pfielding/Voron/Mods/Filament_Spool_Rack/Stls/Bowden Mount.stl

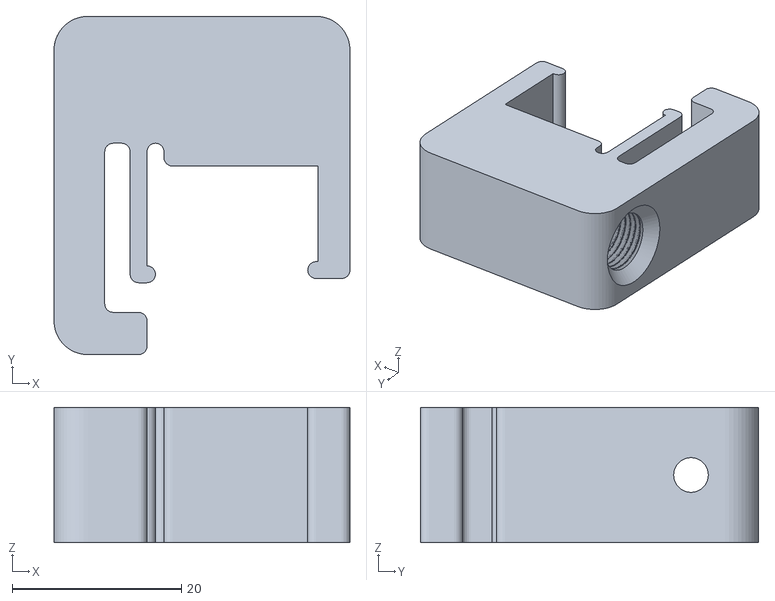
[picture p14: CAD file, 2023-10-17]
Mods/Filament_Spool_Rack/Stls/Bowden Mount.stl
35.0 x 40.0 x 16.0
