pfielding/Voron/Mods/Pika_Extended_Length_Mod/Stls/bar-clip-6.stl

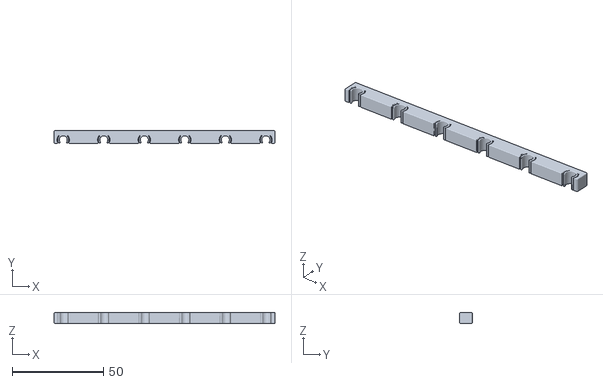
[picture p15: CAD file, 2023-10-17]
Mods/Pika_Extended_Length_Mod/Stls/bar-clip-6.stl
121.3 x 6.89 x 6.00
