pfielding/Voron/Mods/Filament_Spool_Rack/Stls/Slider Standalone.stl

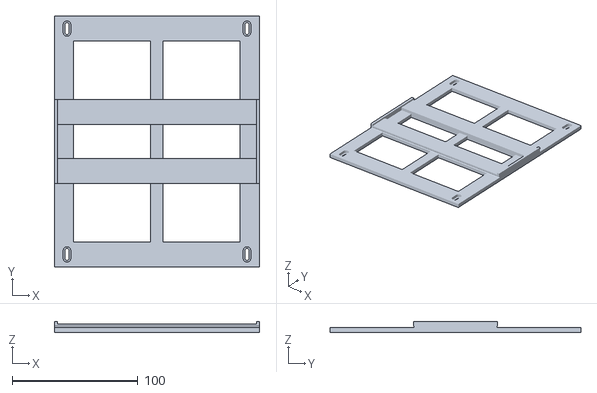
[picture p16: CAD file, 2023-10-17]
Mods/Filament_Spool_Rack/Stls/Slider Standalone.stl
163.4 x 200.0 x 8.93
