pfielding/Voron/Mods/Pika_Extended_Length_Mod/Stls/bar-clip-9.stl

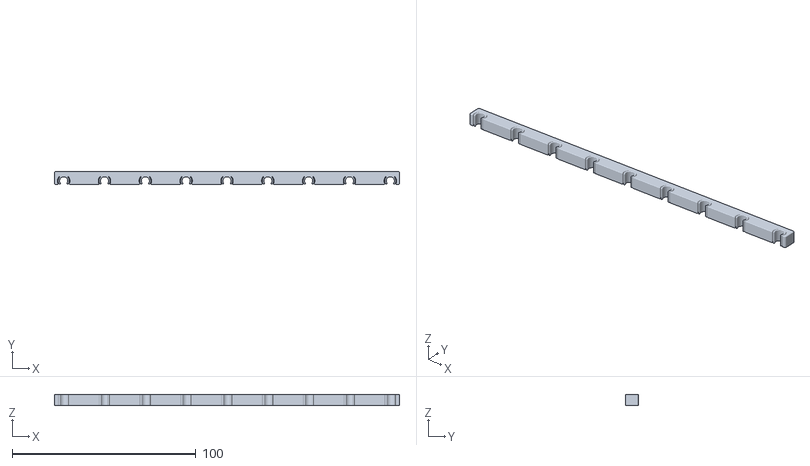
[picture p17: CAD file, 2023-10-17]
Mods/Pika_Extended_Length_Mod/Stls/bar-clip-9.stl
188.0 x 6.89 x 6.00
