pfielding/Voron/Mods/Pika_Extended_Length_Mod/Stls/bar-clip-2.stl

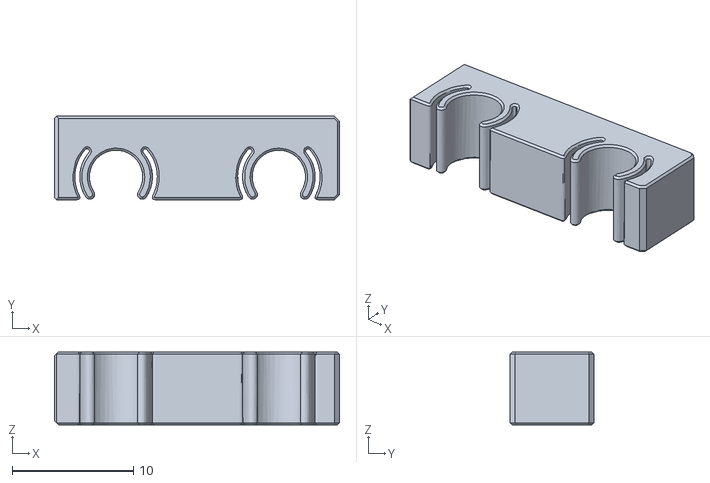
[picture p18: CAD file, 2023-10-17]
Mods/Pika_Extended_Length_Mod/Stls/bar-clip-2.stl
23.5 x 6.89 x 6.00
