pfielding/Voron/Mods/Filament_Spool_Rack/Stls/ERCF Rack Bracket.stl

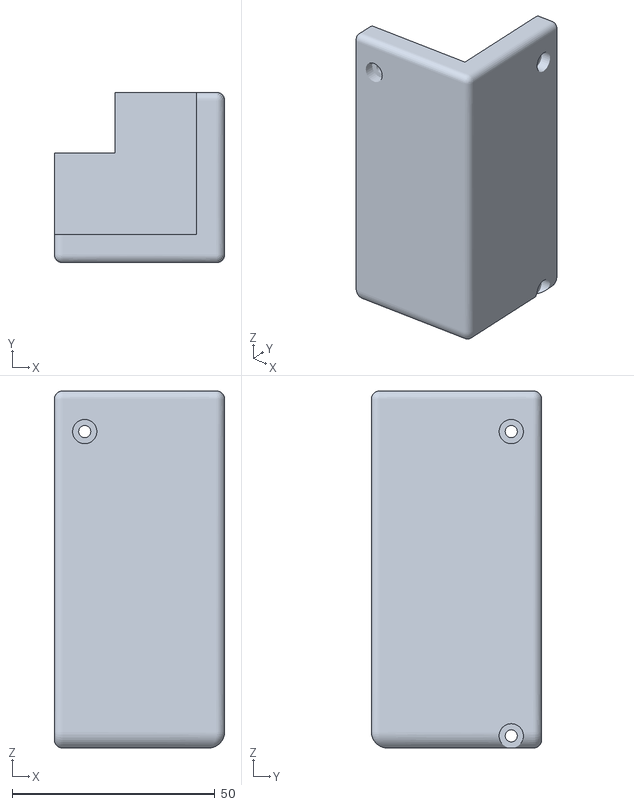
[picture p19: CAD file, 2023-10-17]
Mods/Filament_Spool_Rack/Stls/ERCF Rack Bracket.stl
42.0 x 42.0 x 88.0
