pfielding/Voron/Mods/Pika_Extended_Length_Mod/Stls/filament_bracket_mounting_plate_ercf_notches.stl

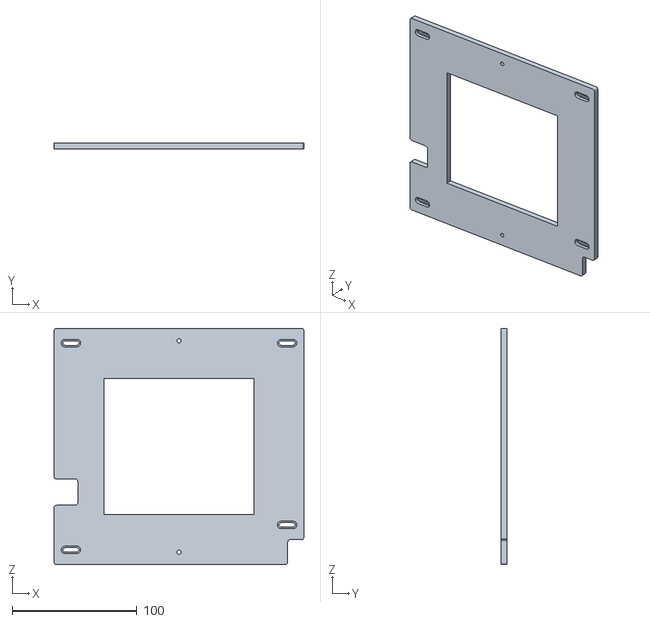
[picture p20: CAD file, 2023-10-17]
Mods/Pika_Extended_Length_Mod/Stls/filament_bracket_mounting_plate_ercf_notches.stl
200.0 x 5.00 x 189.0
