pfielding/Voron/Mods/Filament_Spool_Rack/Stls/Slider Middle.stl

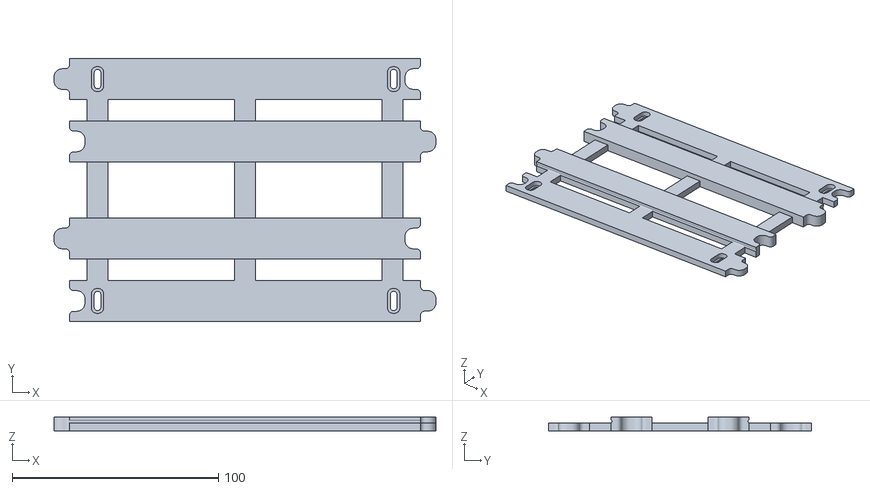
[picture p21: CAD file, 2023-10-17]
Mods/Filament_Spool_Rack/Stls/Slider Middle.stl
185.0 x 127.5 x 7.00
