pfielding/Voron/Mods/Pika_Extended_Length_Mod/Stls/buffer-front-long-a.stl

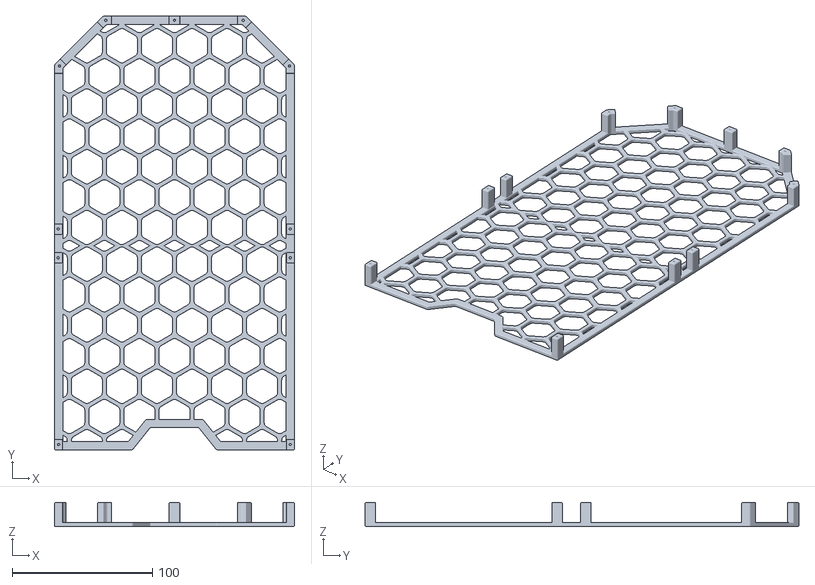
[picture p22: CAD file, 2023-08-23]
Mods/Pika_Extended_Length_Mod/Stls/buffer-front-long-a.stl
171.2 x 309.4 x 17.2
