pfielding/Voron/Mods/Filament_Spool_Rack/Stls/Heatset Side.stl

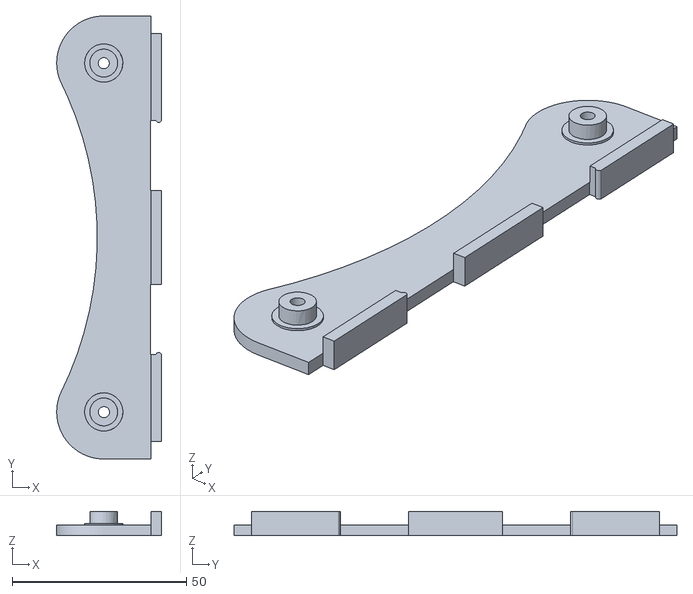
[picture p23: CAD file, 2023-10-17]
Mods/Filament_Spool_Rack/Stls/Heatset Side.stl
30.0 x 127.0 x 7.00
