pfielding/Voron/Mods/Pika_Extended_Length_Mod/Stls/array-front-with-mount-short.stl

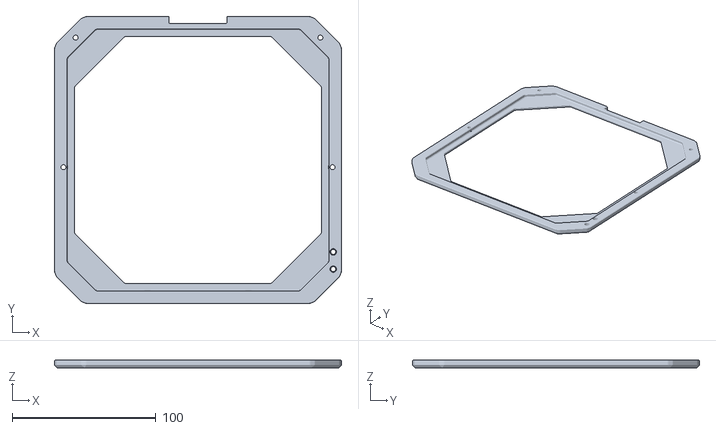
[picture p24: CAD file, 2023-08-23]
Mods/Pika_Extended_Length_Mod/Stls/array-front-with-mount-short.stl
200.0 x 200.0 x 5.40
