pfielding/Voron/Mods/Filament_Spool_Rack/Stls/Slider_End.stl

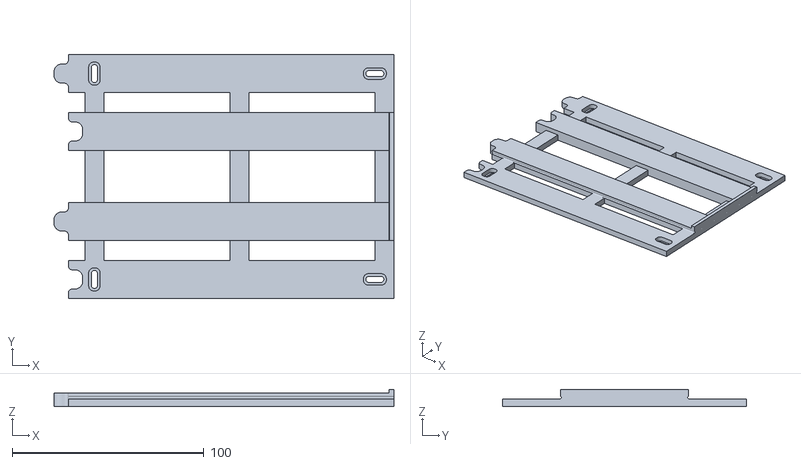
[picture p25: CAD file, 2023-10-17]
Mods/Filament_Spool_Rack/Stls/Slider_End.stl
177.5 x 127.5 x 9.00
