pfielding/Voron/Mods/Pika_Extended_Length_Mod/Stls/pika-tube-support-6-buffers-v3.stl

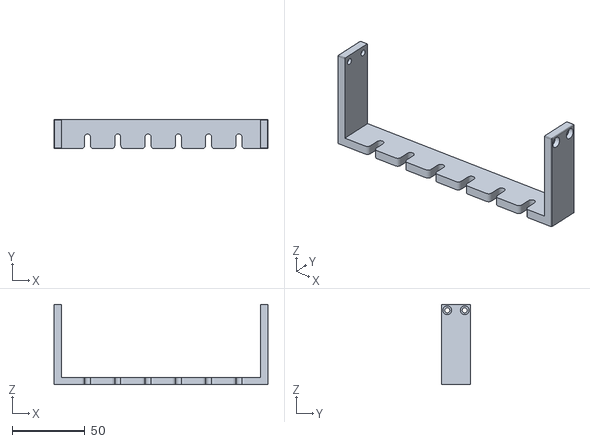
[picture p27: CAD file, 2023-08-23]
Mods/Pika_Extended_Length_Mod/Stls/pika-tube-support-6-buffers-v3.stl
147.0 x 20.0 x 55.0
