pfielding/Voron/Mods/Pika_Extended_Length_Mod/Stls/array-back-with-mount-long-b.stl

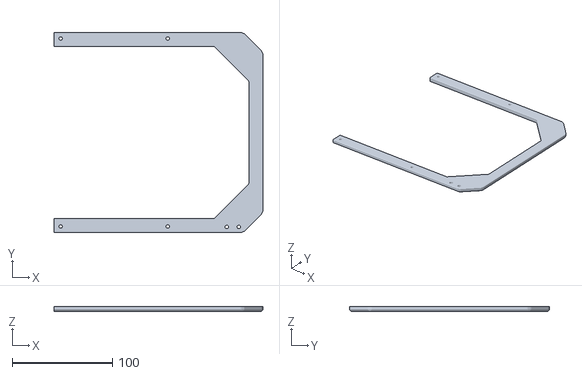
[picture p28: CAD file, 2023-08-23]
Mods/Pika_Extended_Length_Mod/Stls/array-back-with-mount-long-b.stl
208.6 x 200.0 x 5.40
