pfielding/Voron/Mods/Pika_Extended_Length_Mod/Stls/array-front-with-mount-long-a.stl

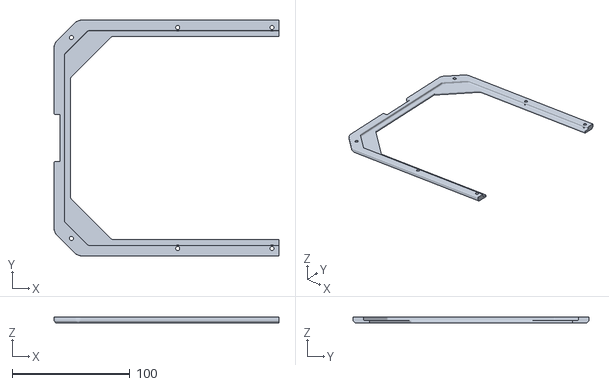
[picture p29: CAD file, 2023-08-23]
Mods/Pika_Extended_Length_Mod/Stls/array-front-with-mount-long-a.stl
191.0 x 200.0 x 5.40
