pfielding/Voron/Mods/Pika_Extended_Length_Mod/Stls/filament_bracket_mounting_plate.stl

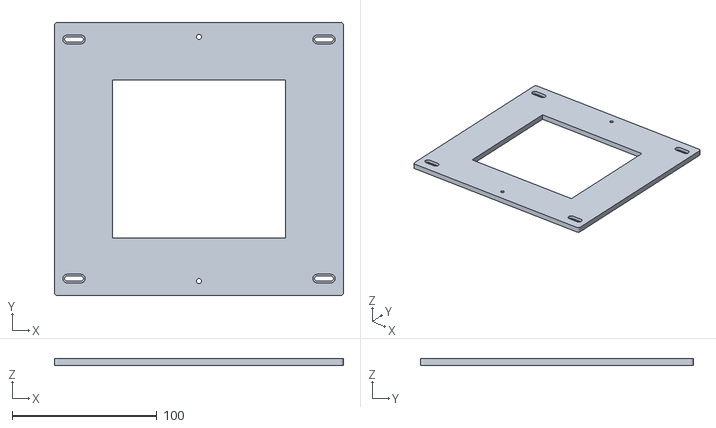
[picture p30: CAD file, 2023-08-23]
Mods/Pika_Extended_Length_Mod/Stls/filament_bracket_mounting_plate.stl
200.0 x 189.0 x 5.00
