pfielding/Voron/Mods/Pika_Extended_Length_Mod/Stls/11mm_magnet_end_v2.stl

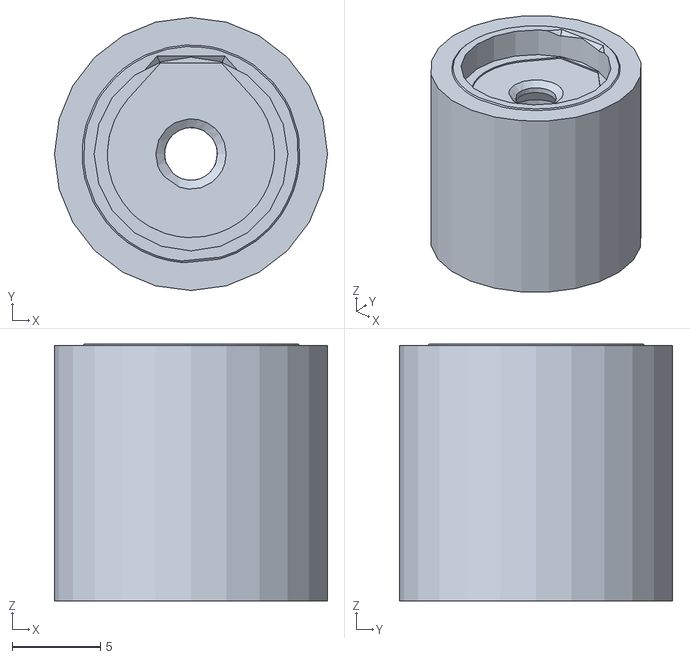
[picture p31: CAD file, 2023-08-23]
Mods/Pika_Extended_Length_Mod/Stls/11mm_magnet_end_v2.stl
15.5 x 15.5 x 14.6
