pfielding/Voron/Mods/Pika_Extended_Length_Mod/Stls/buffer-front-long-b2.stl

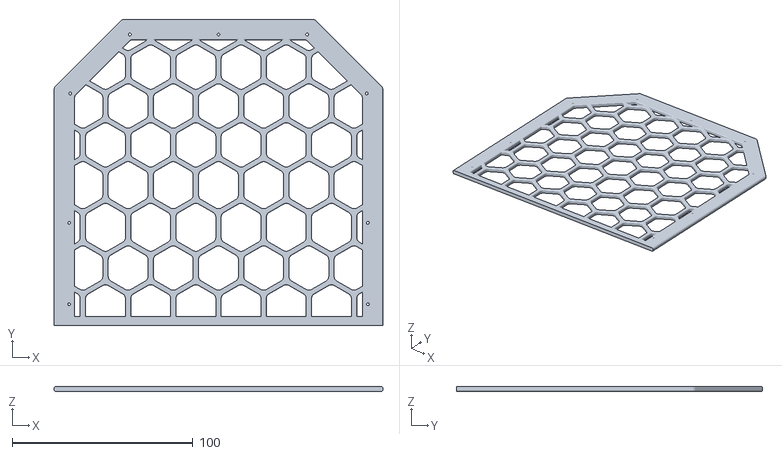
[picture p32: CAD file, 2023-08-23]
Mods/Pika_Extended_Length_Mod/Stls/buffer-front-long-b2.stl
182.0 x 169.5 x 2.80
