pfielding/Voron/Mods/Pika_Extended_Length_Mod/Stls/array-front-screen-long-a.stl

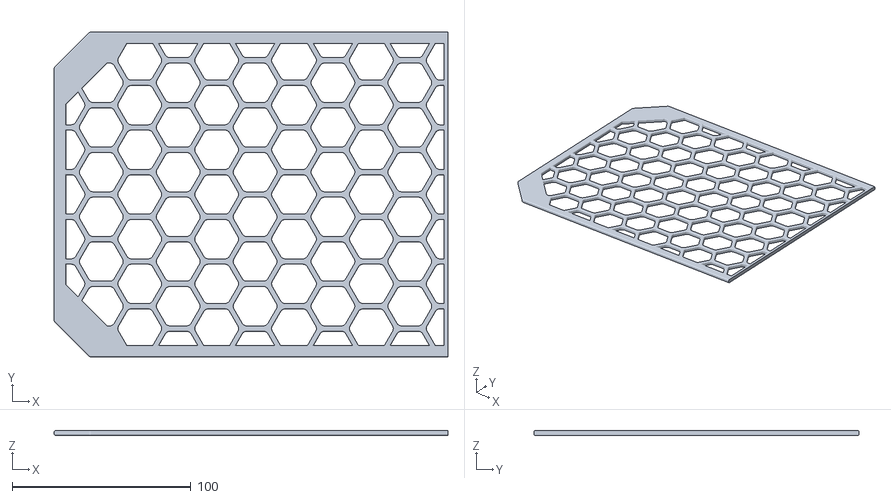
[picture p33: CAD file, 2023-08-23]
Mods/Pika_Extended_Length_Mod/Stls/array-front-screen-long-a.stl
220.4 x 182.0 x 2.80
