pfielding/Voron/Mods/Pika_Extended_Length_Mod/Stls/buffer-front-long-b1.stl

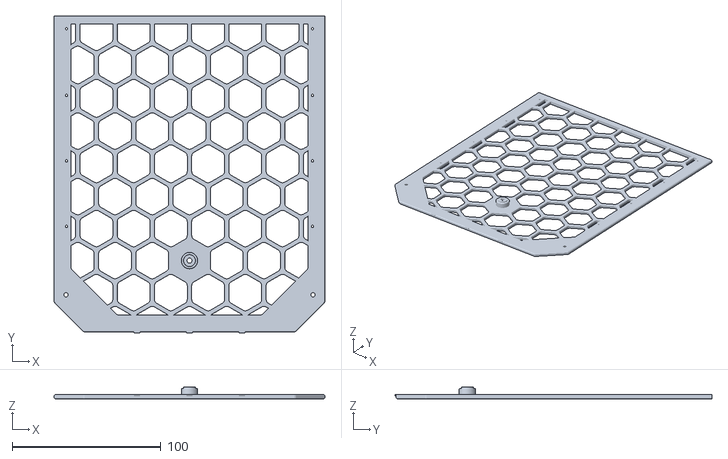
[picture p34: CAD file, 2023-08-23]
Mods/Pika_Extended_Length_Mod/Stls/buffer-front-long-b1.stl
182.0 x 212.8 x 7.80
