pfielding/Voron/Mods/Pika_Extended_Length_Mod/Stls/buffer-bottom-long.stl

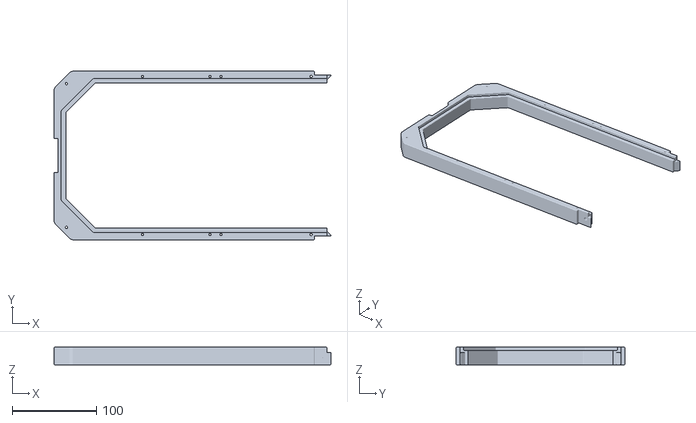
[picture p35: CAD file, 2023-08-23]
Mods/Pika_Extended_Length_Mod/Stls/buffer-bottom-long.stl
328.6 x 200.0 x 20.8
