pfielding/Voron/Mods/Pika_Extended_Length_Mod/Stls/11mm_buffer-top-magnet+magnet_v2.stl

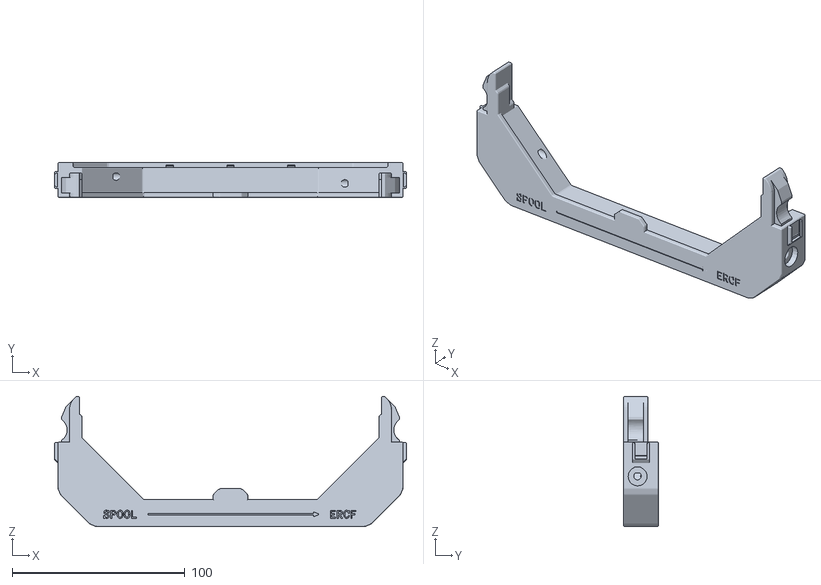
[picture p36: CAD file, 2023-08-23]
Mods/Pika_Extended_Length_Mod/Stls/11mm_buffer-top-magnet+magnet_v2.stl
204.0 x 20.0 x 75.4
