pfielding/Voron/Mods/Pika_Extended_Length_Mod/Stls/array-front-screen-long-b.stl

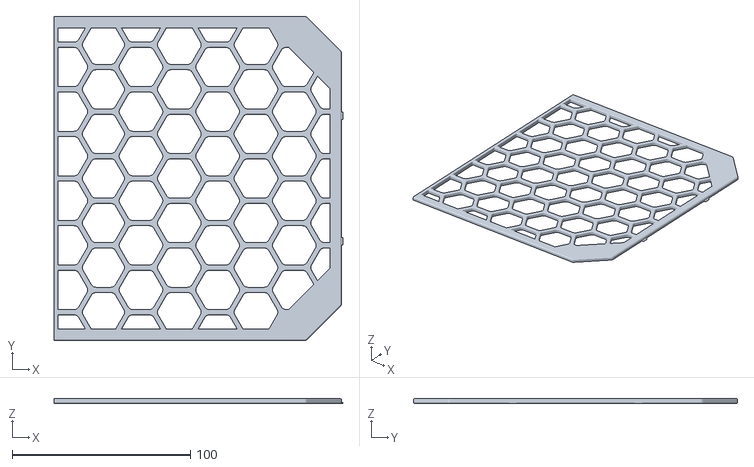
[picture p37: CAD file, 2023-08-23]
Mods/Pika_Extended_Length_Mod/Stls/array-front-screen-long-b.stl
162.1 x 182.0 x 2.80
