pfielding/Voron/Mods/Pika_Extended_Length_Mod/Stls/array-bottom-bracket-6-3mmHole.stl

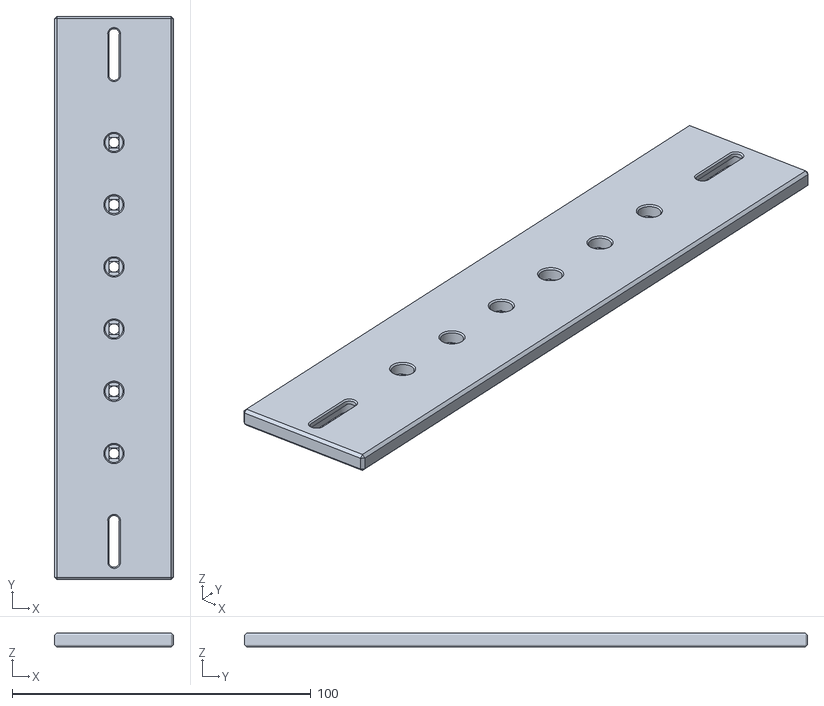
[picture p38: CAD file, 2023-08-23]
Mods/Pika_Extended_Length_Mod/Stls/array-bottom-bracket-6-3mmHole.stl
39.8 x 188.4 x 4.80
