pfielding/Voron/(list of files, cad)

Other CAD files:
Mods/Pika_Extended_Length_Mod/Stls/array-back-with-mount-short.stl
Mods/Pika_Extended_Length_Mod/Stls/array-back-with-mount-long-a.stl
Mods/Bolted_Door_Handle/Backplate_handle_x4.stl
Mods/Bolted_Door_Handle/Stls/latch_for_handle_heatset_x2.stl
Mods/Bolted_Door_Handle/Stls/mod_6x3_handle_a_small_A_heatset_x2.stl
Mods/Bolted_Door_Handle/Stls/mod_6x3_handle_a_small_B_heatset.stl
Mods/Filament_Spool_Rack/Stls/Screw Side.stl
