pfielding/Voron/(commit log)

2023-08-05 Bolted Door Handle
    Initial Commit
    [Backplate_handle_x4.stl, latch_for_handle_heatset_x2.stl, mod_6x3_handle_a_small_A_heatset_x2.stl, mod_6x3_handle_a_small_B_heatset.stl]
2023-08-23 Added Pika Extended Length Mod
    Initial commit
    [11mm_buffer-top-magnet+magnet_v2.stl, 11mm_magnet_end_v2.stl, array-back-with-mount-long-a.stl, array-back-with-mount-long-b.stl, array-back-with-mount-short.stl, array-bottom-bracket-6-3mmHole.stl, array-front-screen-long-a.stl, array-front-screen-long-b.stl]
2023-08-23 Organizational Cleanup
    [11mm_buffer-top-magnet+magnet_v2.stl, 11mm_magnet_end_v2.stl, array-back-with-mount-long-a.stl, array-back-with-mount-long-b.stl, array-back-with-mount-short.stl, array-bottom-bracket-6-3mmHole.stl, array-front-screen-long-a.stl, array-front-screen-long-b.stl]
2023-10-17 Added Notched mounting plate for use with top mount project
    [filament_bracket_mounting_plate_ercf_notches.stl]
2023-10-17 Added Geoff's bar-clip and a 2 bowden modded version
    [bar-clip-2.stl, bar-clip-6.stl, bar-clip-9.stl]
2023-10-17 Added Filament Spool Rack initial commit
    [Bowden Mount.stl, ERCF Rack Bracket.stl, Heatset Side.stl, Screw Side.stl, Slider Middle.stl, Slider Standalone.stl, Slider_End.stl]
