pfielding/Voron/Mods/Filament_Spool_Rack/Images/top rack 5.jpeg

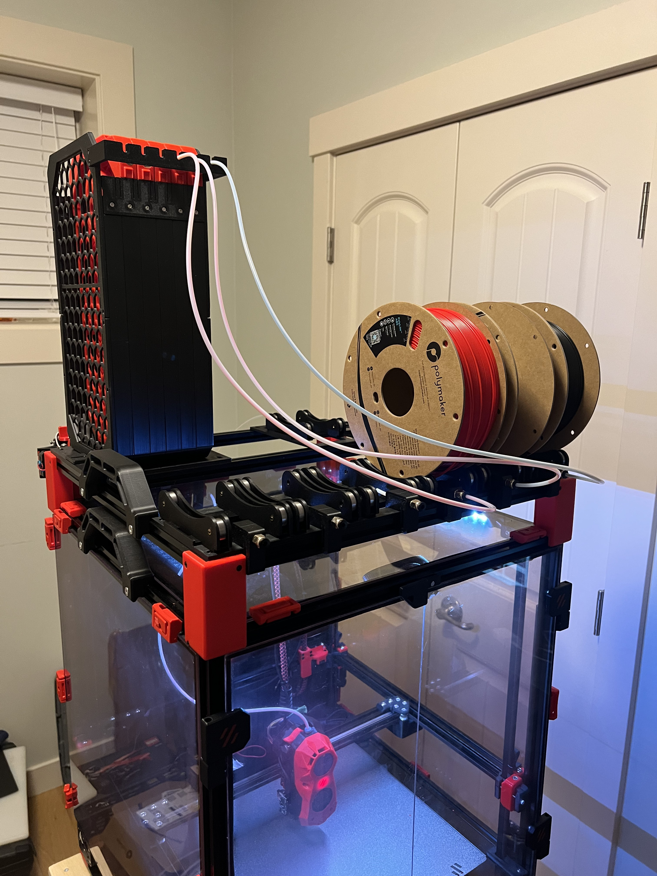
[picture p1: Mods/Filament_Spool_Rack/Images/top_rack_5.jpeg]
Mods/Filament_Spool_Rack/Images/top rack 5.jpeg
