pfielding/Voron/Mods/Filament_Spool_Rack/Images/top rack 6.jpeg

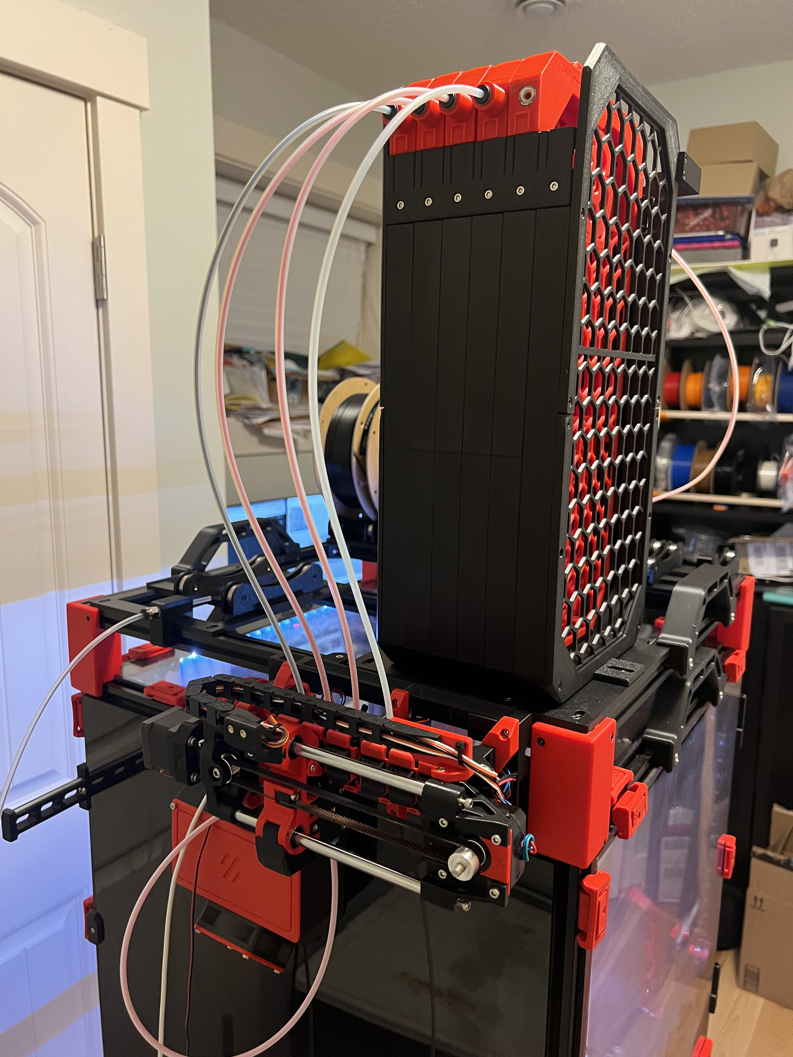
[picture p2: Mods/Filament_Spool_Rack/Images/top_rack_6.jpeg]
Mods/Filament_Spool_Rack/Images/top rack 6.jpeg
