pfielding/Voron/Mods/Filament_Spool_Rack/Images/top rack 2.jpeg

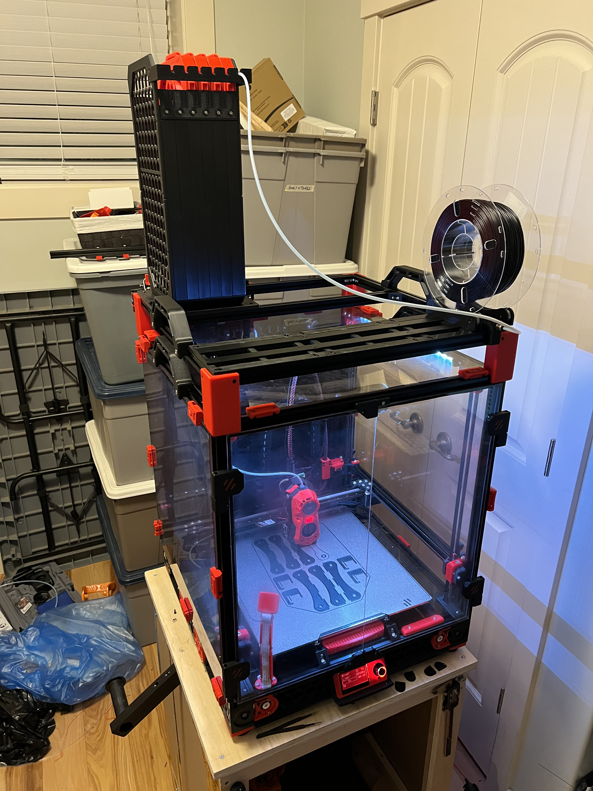
[picture p4: Mods/Filament_Spool_Rack/Images/top_rack_2.jpeg]
Mods/Filament_Spool_Rack/Images/top rack 2.jpeg
