pfielding/Voron/Mods/Pika_Extended_Length_Mod/Images/ExtendedArray.jpeg

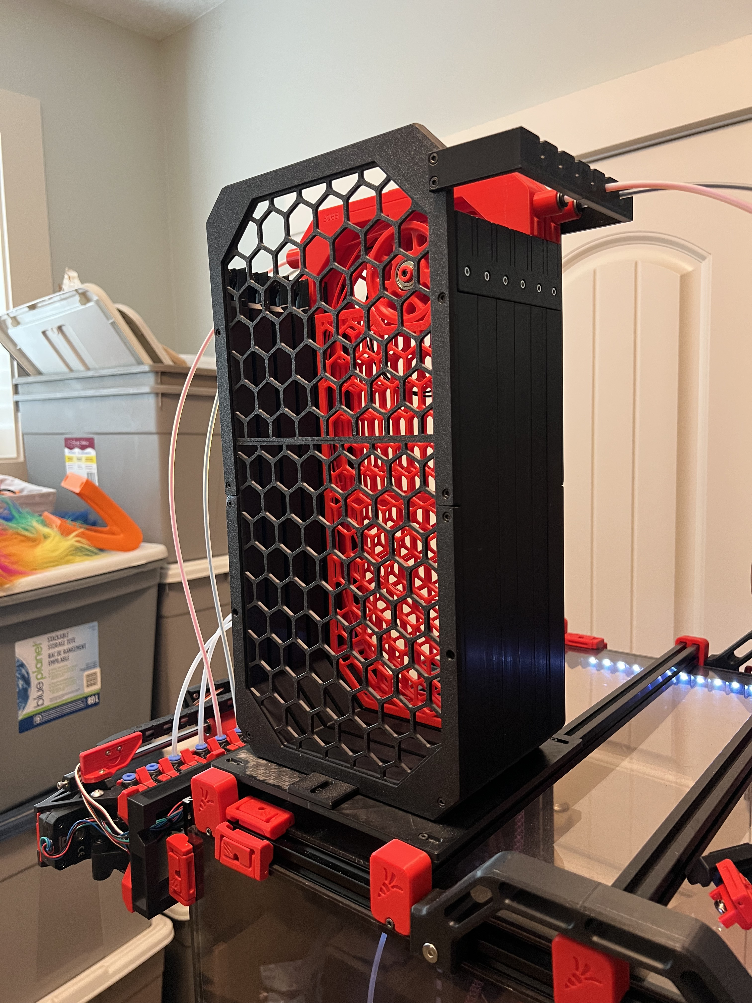
[picture p7: Mods/Pika_Extended_Length_Mod/Images/ExtendedArray.jpeg]
Mods/Pika_Extended_Length_Mod/Images/ExtendedArray.jpeg
