pfielding/Voron/Mods/Pika_Extended_Length_Mod/Images/BowdenSupport.jpeg

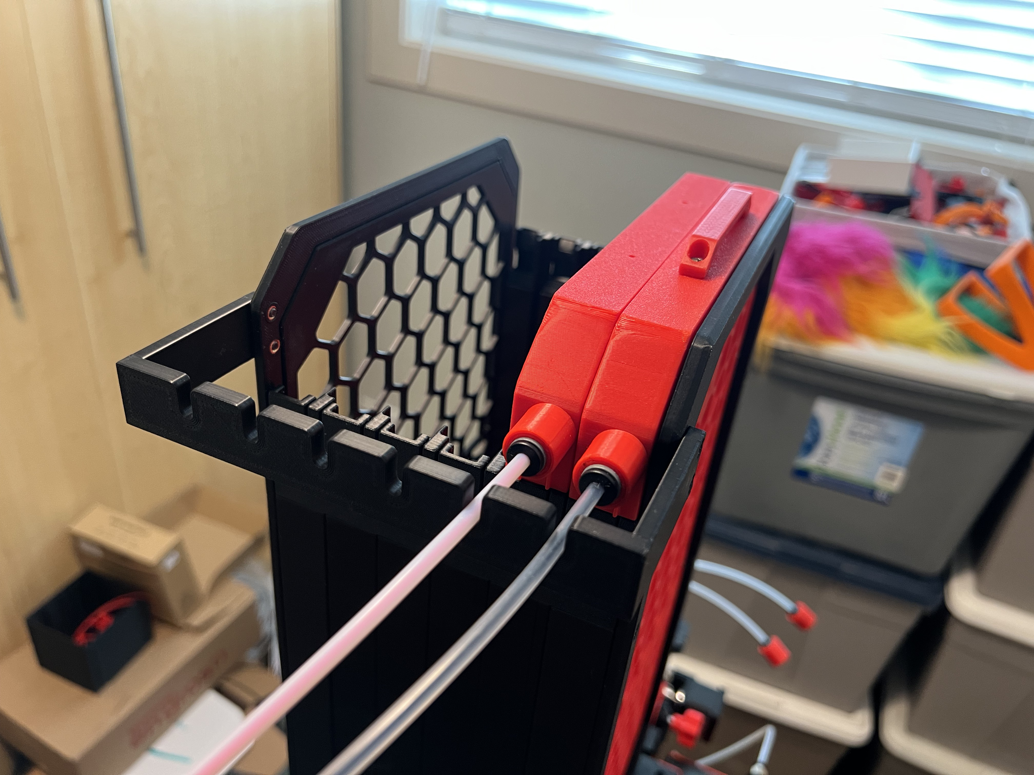
[picture p9: Mods/Pika_Extended_Length_Mod/Images/BowdenSupport.jpeg]
Mods/Pika_Extended_Length_Mod/Images/BowdenSupport.jpeg
